aboudou/onepixelblecamera/3dFiles/cameraAssembly.stl

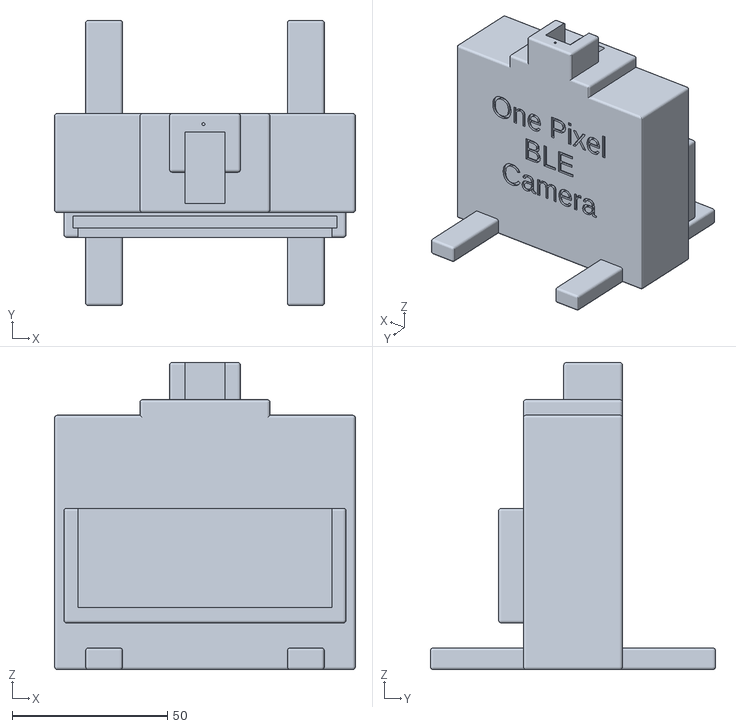
[picture p17: CAD file, 2026-04-08]
3dFiles/cameraAssembly.stl
97.0 x 92.0 x 99.0
