aboudou/onepixelblecamera/3dFiles/bpw34_support_70_4.0.stl

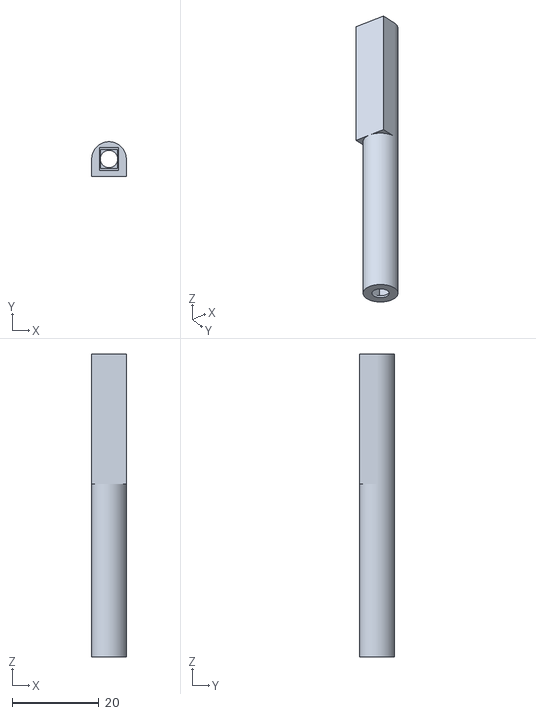
[picture p18: CAD file, 2026-04-08]
3dFiles/bpw34_support_70_4.0.stl
8.00 x 8.00 x 70.0
