aboudou/onepixelblecamera/3dFiles/ldr_support_70_1.0.stl

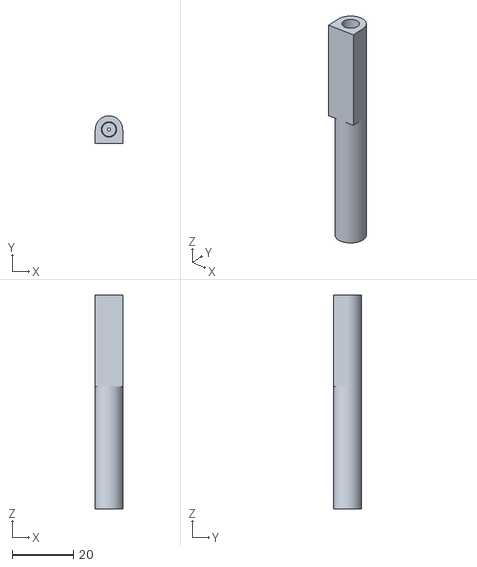
[picture p19: CAD file, 2026-04-08]
3dFiles/ldr_support_70_1.0.stl
9.00 x 9.00 x 70.0
