aboudou/onepixelblecamera/(list of files, cad)

Other CAD files:
3dFiles/ldr_support.scad
