aboudou/onepixelblecamera/kicad/onePixelBleCamera/onePixelBleCamera.pdf

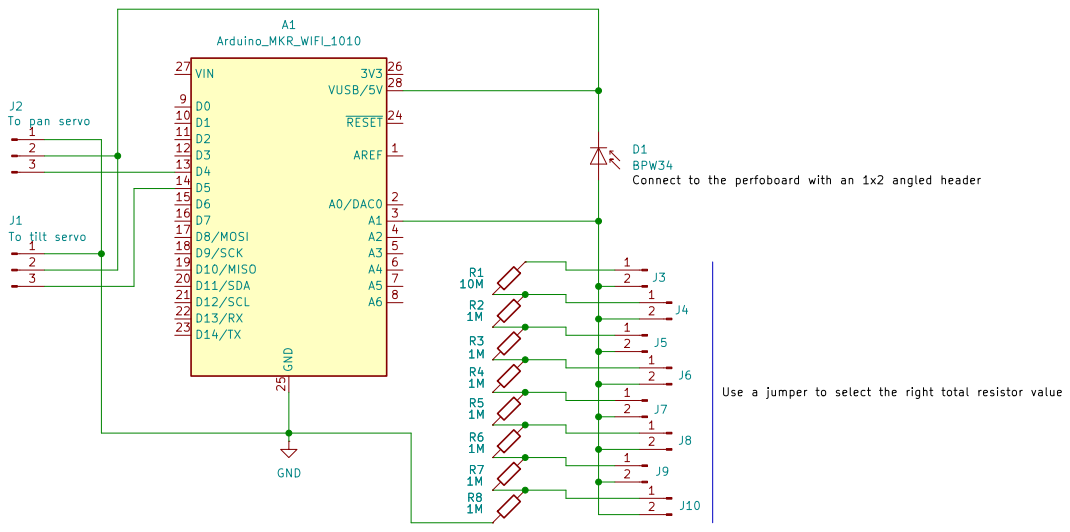
[picture p20: page 1]

Use a jumper to select the right total resistor value Connect to the perfoboard with an 1x2 angled header R7
